shanshrawat/quadrature-down-converter/report/QDC_Report.pdf

# Prototype Implementation of a Quadrature Down Converter

Shreyansh Rawat | Shreyaas Sarkaar | Hiten Arora
2025102105 | 2025112020 | 2025102101
Analog Electronic Circuits (EC2.103) IIIT Hyderabad, Hyderabad, India

Abstract—This paper presents the design, analysis, simulation, and hardware prototype of a Quadrature Down Converter (QDC) operating at a local oscillator frequency of 170 kHz and producing a 5 kHz intermediate frequency (IF) output. The architecture consists of four cascaded stages: (i) a Wien-bridge quadrature oscillator generating 90°-separated sine and cosine signals at 170 kHz, (ii) two NMOS switching mixers multiplying the 175 kHz RF input against each oscillator phase, (iii) passive RC low-pass filters with a −3 dB cutoff near 4.82 kHz for image rejection, and (iv) a common-source NMOS amplification stage delivering a final output amplitude of 400 mV peak-to-peak. System behaviour is validated through LTspice simulations using TSMC 180 nm MOSFET models and UA741 op-amp models, then compared against laboratory hardware measurements. Key nonidealities—including Barkhausen gain sensitivity, op-amp bandwidth constraints, MOSFET body effect, and mixing conversion loss—are identified and their effects on prototype performance are discussed.
Index Terms— Quadrature down-conversion, Wien bridge oscillator, switching mixer, low-pass filter, common-source amplifier, direct conversion, RF receivers.
I. INTRODUCTION

Frequency down-conversion is a foundational operation in modern wireless receivers, translating a high-frequency radiofrequency (RF) carrier to a lower intermediate frequency (IF) where filtering and demodulation are more easily implemented. The superheterodyne architecture achieves this with a single mixer, but its inability to separate positive and negative spectral components mandates a bulky image-rejection filter at RF [1]. Direct-conversion (zero-IF) receivers eliminate this filter by translating the desired channel directly to baseband, but doing so with a single mixer causes the negative-frequency half of the downconverted channel to fold over and superpose onto the positive-frequency half, destroying the signal [1]. Quadrature downconversion resolves this fundamental limitation.
In a Quadrature Down Converter, the incoming RF signal vin = A1 cos(ωint) is split into two parallel paths and mixed with two local oscillator (LO) signals that maintain a strict 90° phase difference:
vOSCI = A2 cos(ωOSC t), | (1)
vOSCQ = A2 sin(ωOSC t). | (2)

The product of mixing yields in-phase (I) and quadraturephase (Q) IF signals:

vIFI = vin × vOSCI =

A1A2
2
cos(ωin − ωOSC)t + cos(ωin + ωOSC)t
,
(3)

vIFQ = vin × vOSCQ =

A1A2
2
sin(ωin + ωOSC)t − sin(ωin − ωOSC)t
(4)

Subsequent low-pass filtering removes the high-frequency sum terms, retaining only the difference-frequency IF components at fIF = fin − fOSC. The 90° phase relationship between vIFI and vIFQ is preserved after filtering, enabling unambiguous complex-baseband demodulation. A critical practical requirement is that fin ̸= fOSC; were they equal, the mixer would self-mix and produce a DC offset that corrupts the baseband signal [1]. In this implementation, fOSC = 170 kHz and fin = 175 kHz, yielding fIF = 5 kHz.

II. UTILITY OF QUADRATURE (I-Q) OPERATION

The necessity of quadrature downconversion becomes clear when considering the spectrum of a direct-conversion receiver. When a real passband signal centered at fc is multiplied by a single-phase cosine LO at fc, the result contains both fin − fOSC and fin + fOSC components. For a narrowband modulated signal, the lower sideband (desired IF) and the image of the upper sideband overlap at the same frequency after downconversion, causing irreversible spectral aliasing. Quadrature operation constructs the complex-valued analytic signal vBB(t) = vIFI(t) + j vIFQ(t), whose one-sided spectrum contains only positive frequencies. The image channel, which appears at −fIF in the complex representation, is completely separable from the desired signal at +fIF. Abidi [1] shows that even with imperfect quadrature—for instance, a 1° LO phase error combined with 0.1 dB gain mismatch—image rejection exceeds 40 dB, which is sufficient for most wireless standards. This makes the QDC architecture robust against practical implementation imperfections while eliminating the need for a high-selectivity RF image-reject filter, significantly reducing system complexity and power consumption in integrated receivers.

III. QUADRATURE OSCILLATOR DESIGN

A. (a) Topology Selection

The quadrature oscillator was implemented using the twoop-amp RC phase-shift topology presented in the Texas Instruments application note by Mancini [4]. The topology naturally generates two sinusoidal outputs separated by 90° phase difference, labelled:

vOSCI = A cos(ω0t), | (5)
vOSCQ = A sin(ω0t). | (6)

Compared to Wien-bridge or Bubba oscillators, the quadrature topology was selected because:
- it directly produces both sine and cosine outputs,
- it requires only two op-amps,
- the oscillation frequency depends on a single RC product,
- the 90° phase relationship is inherently guaranteed by the RC-integrator structure.
The practical implementation used two UA741 operational amplifiers, two RC integrating sections, and nonlinear diode stabilization networks for amplitude control.
B. (b) Barkhausen Criterion and Oscillation Condition

For sustained oscillation, the Barkhausen criterion must be satisfied:
Aβ = 1∠ − 180◦ | (7)

For the quadrature oscillator topology, the TI analysis gives:

ω0 =

1
RC | (8)

Therefore:
f0 =

1
2πRC | (9)

At this frequency, each RC section contributes approximately 90° phase shift, producing the required total loop phase condition for oscillation and yielding two outputs separated by 90°.

C. (c) Component Calculation for 170 kHz Operation

The assigned oscillation frequency is:

f0 = 170 kHz | (10)

Using Eq. (9):

RC =

1 2πf0 | (11)

Substituting:

RC =

1 2π × 170 × 10³
≈ 9.36 × 10⁻⁷ | (12)

Selecting:
C = 1 nF | (13)

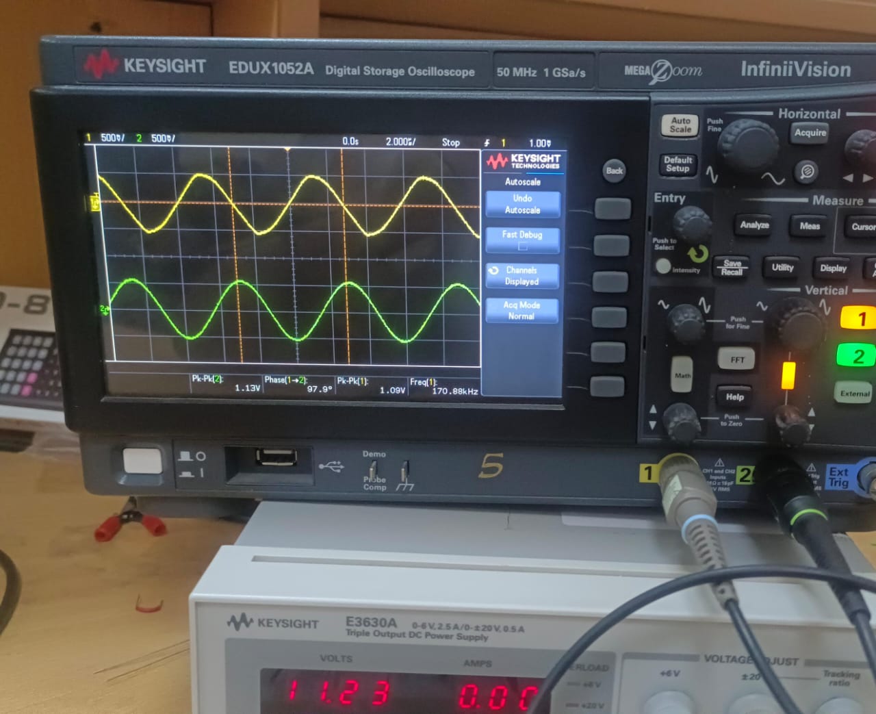
[picture p23: figure]

Fig. 1: Transient analysis of oscillator on DSO

gives:

R =

9.36 × 10⁻⁷
1 × 10⁻⁹
≈ 936 Ω | (14)

Nearest standard resistor values are:

R ≈ 910 Ω or 1 kΩ | (15)

However, practical testing with UA741 op-amps showed that ideal values did not sustain stable oscillation because of finite gain-bandwidth limitations and excess phase shift. Therefore, experimentally tuned resistor values were used:

R5 = 736 Ω | (16)
R6 = 750 Ω | (17)
C8 = 1 nF | (18)
C9 = 1 nF | (19)

These values produced reliable startup and stable oscillation close to the target frequency in hardware.

D. (d) Supply Voltage Selection

The oscillator used:

VDD = +12 V | (20)
VSS = −12 V | (21)

The UA741 is not rail-to-rail and cannot operate correctly from low single-supply voltages. Dual ±12 V rails ensure:
- sufficient output voltage swing,
- improved linear operating range,
- reduced clipping distortion,
- reliable oscillator startup.
E. (e) Practical Non-Idealities and Amplitude Stabilization

The ideal TI quadrature oscillator assumes:
- ideal op-amps,
- infinite open-loop gain,
- zero parasitic phase shift,
- exact loop gain of unity.

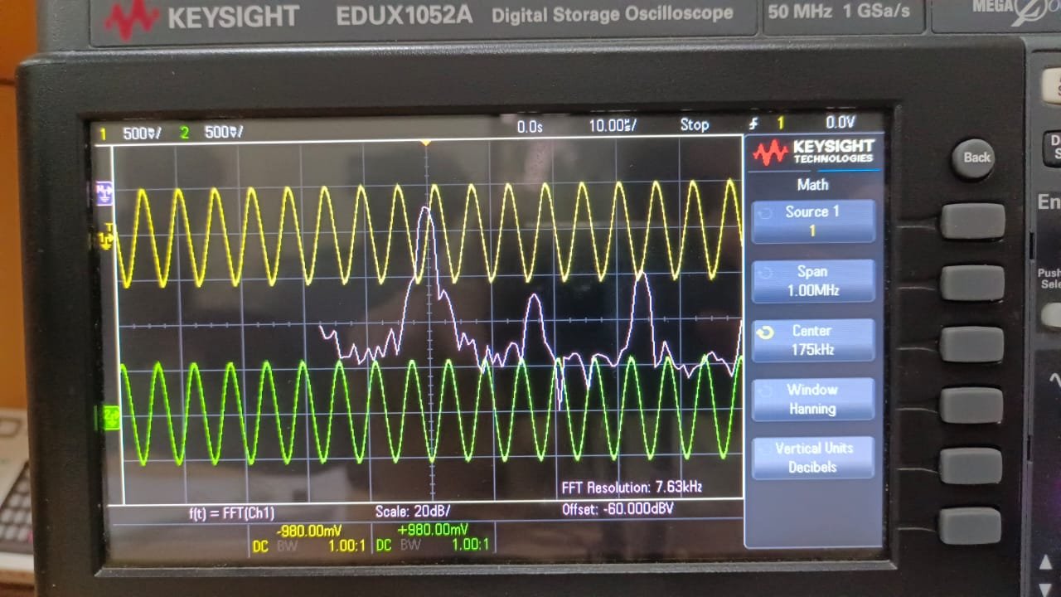
[picture p24: figure]

Fig. 2: FFT of Oscillator

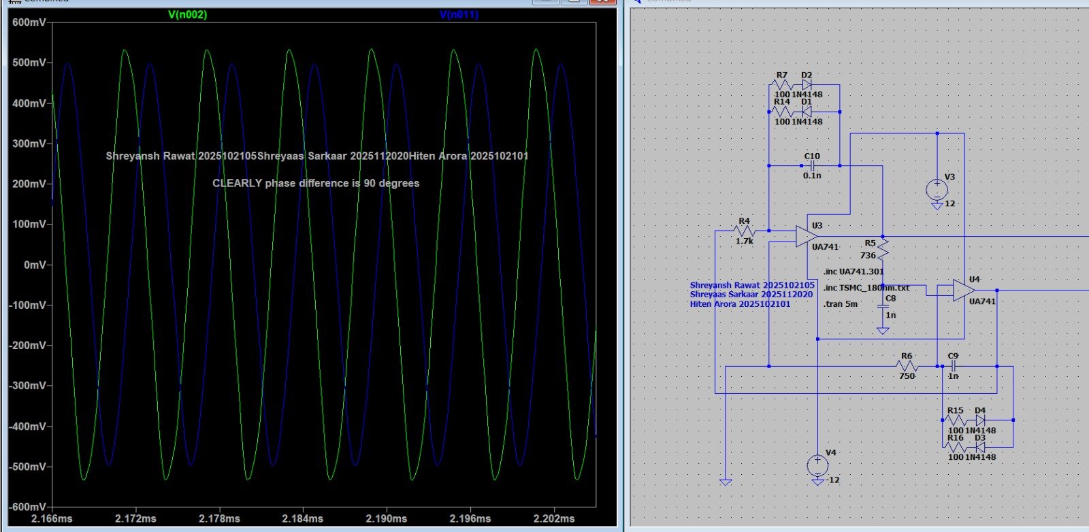
[picture p25: figure]

Fig. 3: 90 degree phase difference observed in simulation

In practical hardware using UA741 op-amps, several non-ideal effects appear:
- finite gain-bandwidth product (GBW ≈ 1 MHz),
- slew-rate limitation,
- input offset voltage,
- parasitic capacitances,
- component tolerances.
At 170 kHz, the available open-loop gain of the UA741 is:

AOL ≈

GBW
f0

=

10⁶
170 × 10³
≈ 5.9 | (22)

This leaves very little margin above the required loop gain, causing the practical oscillation frequency and amplitude to deviate from ideal calculations.
Initially, the oscillator either:
- failed to start, or
- produced clipped waveforms due to excessive gain.
To stabilize the oscillation amplitude near the required 1 VP P , nonlinear diode feedback networks were added using:
D1, D2, D3, D4 : 1N4148 diodes | (23)
R7, R14, R15, R16 : 100 Ω | (24)

The antiparallel diode network acts as an automatic gain control (AGC) mechanism:
- at low amplitudes, the diodes remain OFF and the loop gain is high enough for startup,
- at large amplitudes, the diodes conduct and reduce the effective feedback resistance,
- this decreases the loop gain toward unity and prevents output clipping.
This practical stabilization network was necessary to obtain stable sinusoidal oscillations in real hardware.

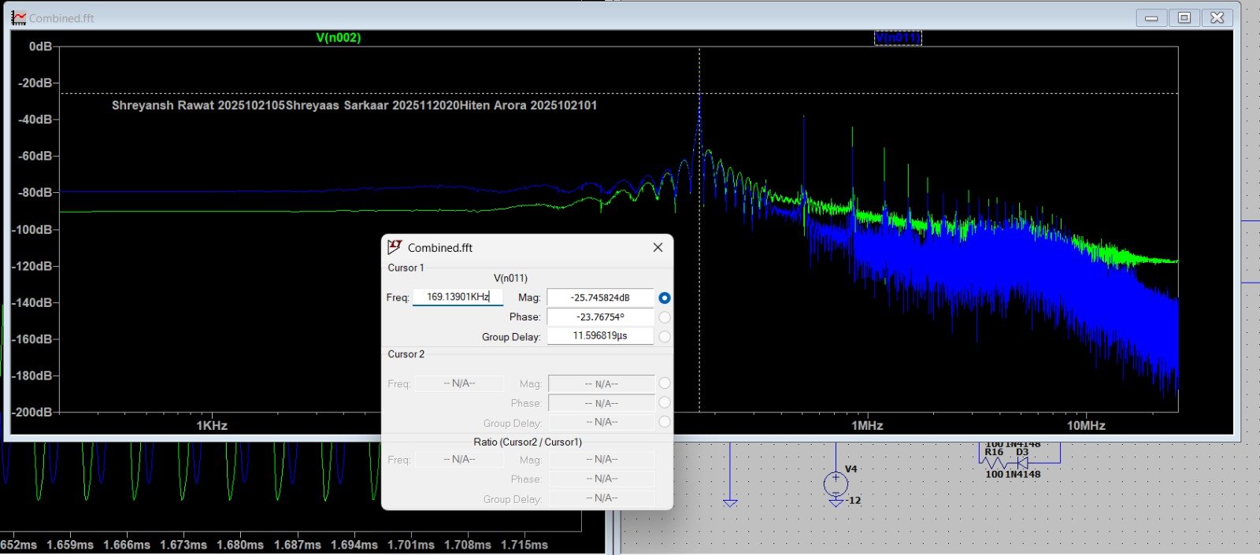
[picture p26: figure]

Fig. 4: Fourier Transform

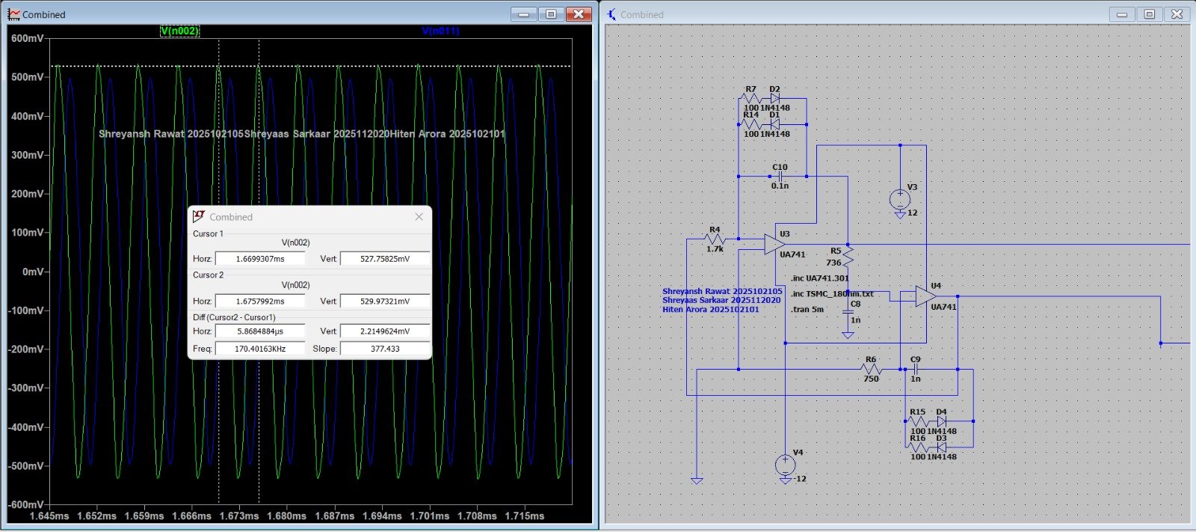
[picture p27: figure]

Fig. 5: Complete Oscillator Transient plots

F. (f) Oscillator Performance

LTspice transient simulation confirmed:
- oscillation frequency near 170 kHz,
- two outputs separated by approximately 90°,
- steady-state amplitude near 1 VP P .
The practical hardware oscillator showed small deviations from ideal behaviour due to:
- UA741 bandwidth limitations,
- resistor/capacitor tolerances,
- diode nonlinearities,
- breadboard parasitic capacitances.
Nevertheless, the oscillator successfully satisfied the project requirements for:
- 170 kHz oscillation frequency,
- quadrature (I/Q) outputs,
- approximately 1 VP P sinusoidal amplitude.

IV. SWITCH (MIXER) DESIGN

A. Operating Principle and Conversion Gain

An NMOS transistor operates as a switching mixer by toggling between cutoff (VGS < VTH) and deep triode (VGS ≫ VTH, VDS ≪ 2(VGS − VTH)) in response to the LO signal applied at its gate. In the triode region:

ID = µnCox

W
L
(VGS − VTH)VDS −

V

2
DS
2
≈ µnCox

W
L

(VGS−VTH)VDS,

(25)
so the drain-source path presents a linear resistance:

RON =

1

µnCox

W
L

(VGS − VTH)

. | (26)

The switching function s(t) that describes the transistor state can be expressed as a Fourier series. For a 50% dutycycle square-wave LO:
s(t) = 1
2

+

2
π

cos(ωOSCt) −

2
3π

cos(3ωOSCt) + · · · (27)

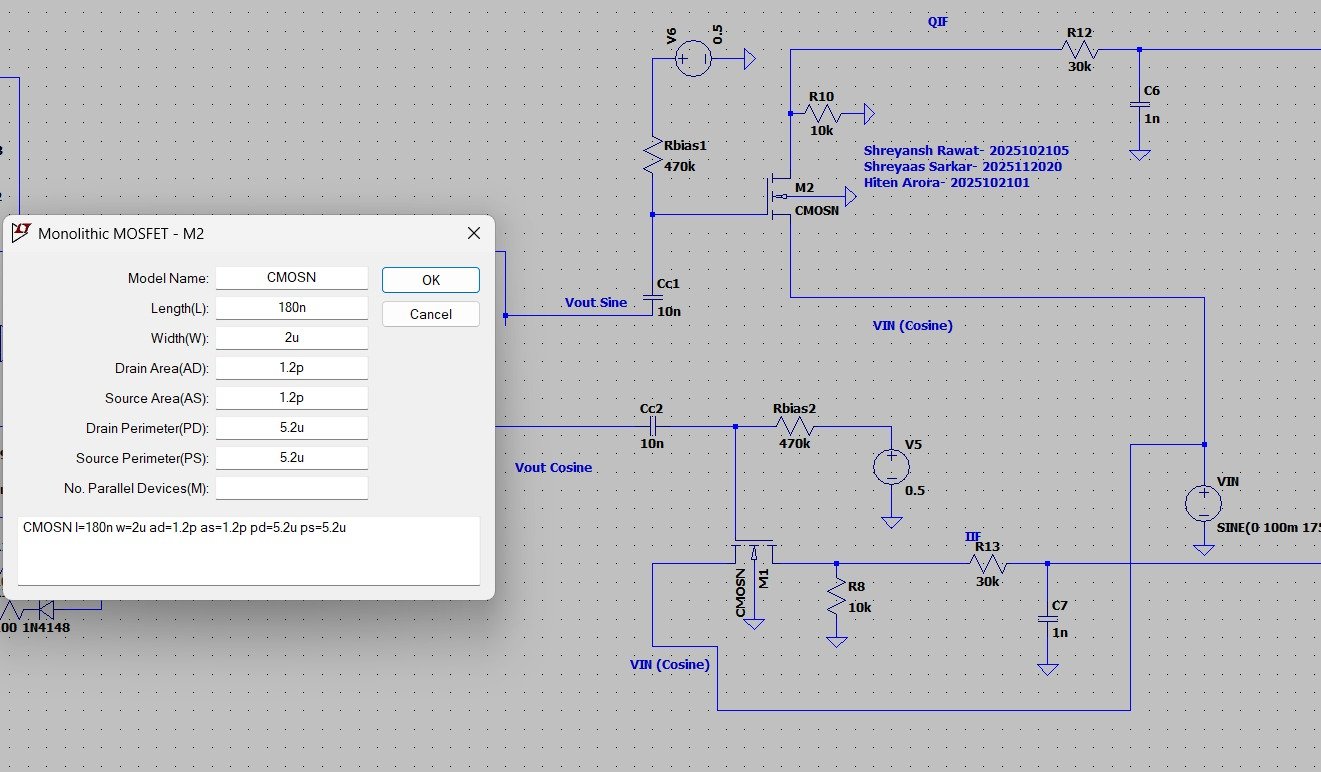
[picture p28: figure]

Fig. 6: MOSFET dimensions

Multiplying by the RF input A1 cos(ωint) and isolating the IF component at ωin − ωOSC:

v

fund
IF =

A1
π
cos(ωIFt). | (28)

This gives a theoretical conversion gain of 1/π ≈ −9.9 dB relative to the RF input amplitude — an inherent loss of this passive switching topology. The 50% duty cycle is critical: it maximises the 2/π fundamental coefficient, suppresses evenorder harmonics (which would fall at 2fOSC±fIF), and ensures the I/Q channels have identical conversion characteristics.

B. (b) MOSFET Dimensions and Parasitic Parameters (W, L, AS, AD, PS, PD)

The switching mixer was implemented using a TSMC 180 nm NMOS transistor model in LTspice. Since physical laboratory MOSFETs have fixed geometry, the transistor dimensions and parasitic parameters were optimized within the simulation environment to achieve improved switching behaviour, acceptable ON resistance, and stable operation at the selected operating frequency of 170 kHz.
The following MOSFET dimensions and parasitic parameters were used in LTspice simulation:

TABLE I: NMOS Mixer Device Parameters Used in LTspice

Parameter | Value
Channel Length (L) | 180 nm
Channel Width (W) | 2 µm
Drain Area (AD) | 1.2 pm²
Source Area (AS) | 1.2 pm²
Drain Perimeter (PD) | 5.2 µm
Source Perimeter (PS) | 5.2 µm
Multiplicity (M) | 1

The transistor aspect ratio is therefore:

W
L

=

2 µm
180 nm
≈ 11.1 | (29)

A larger W/L ratio reduces the MOSFET ON resistance:

RON =

1

µnCox

W
L

(VGS − VTH)

(30)

which improves switching efficiency and reduces conversion loss in the mixer stage.
However, excessively large device width increases parasitic capacitances such as:
- gate-source capacitance (Cgs),
- gate-drain capacitance (Cgd),
- junction capacitances.
These parasitic capacitances degrade high-frequency switching performance and increase LO feedthrough. Therefore, the chosen dimensions represent a tradeoff between:
- low ON resistance,
- acceptable parasitic capacitance,
- improved switching speed,
- reduced conversion loss,
- stable mixer operation at 170 kHz.
The drain/source areas and perimeters were included in the LTspice model to account for diffusion capacitances and junction parasitics more accurately. These parasitic effects influence:
- mixer isolation,
- LO leakage,
- switching transition speed,
- harmonic distortion,
- frequency response.
Although the physical hardware MOSFET dimensions could not be modified, optimization of these parameters in simulation helped predict realistic mixer behaviour and guided the practical hardware implementation.
Gate biasing used:
RBIAS = 470 kΩ | (31)
VBIAS = 0.5 V | (32)
CC = 10 nF | (33)

The DC bias voltage centers the LO waveform near the NMOS threshold voltage to produce approximately 50% switching duty cycle for efficient mixing operation.
A further practical non-ideality is the MOSFET body effect. Since the source terminal is driven by the RF signal rather than fixed at ground, the source-to-body voltage varies during operation, modulating the threshold voltage according to:

VTH = VTH0 + γ

p
2ϕF + VSB −

p
2ϕF
| (34)

This introduces small nonlinearities and harmonic distortion in the IF output, which were observed in FFT simulations as additional harmonic components near the desired IF frequency.

C. Simulation Results — Multi-Frequency Sweep

The mixer was simulated for six input frequencies around the 170 kHz LO: fin ∈ {165, 168, 169, 171, 172, 175} kHz, yielding fIF ∈ {5, 2, 1, 1, 2, 5} kHz respectively. Input amplitude was 100 mV throughout. In each case the IF output appeared at the expected difference frequency in the FFT, confirming correct mixer operation. The conversion gain was

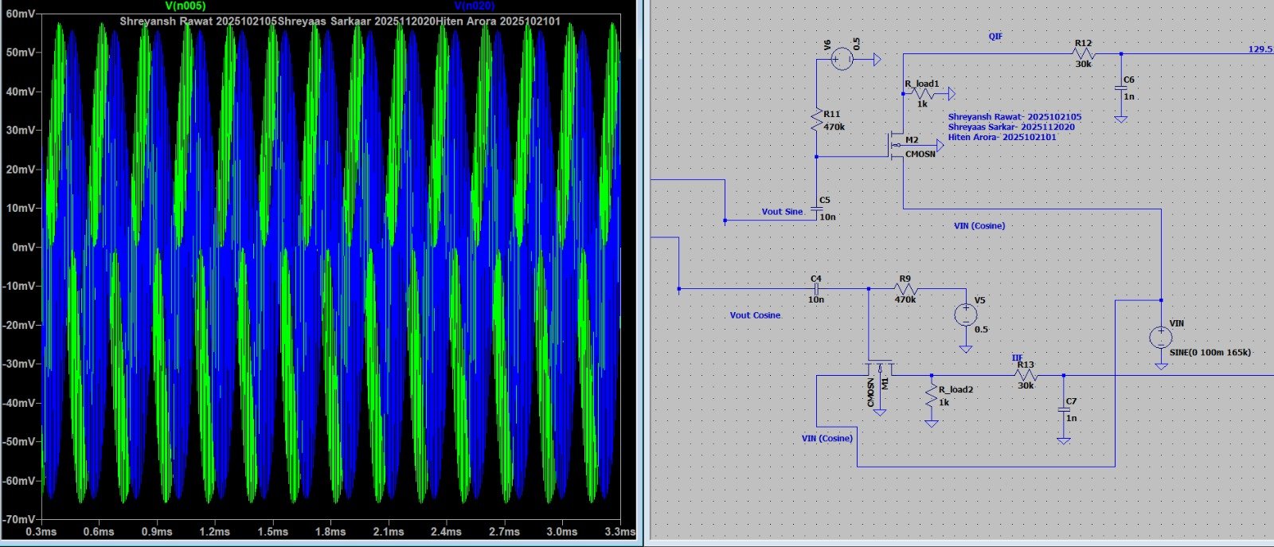
[picture p29: figure]

Fig. 7: Transient plot for fin = 165 kHz

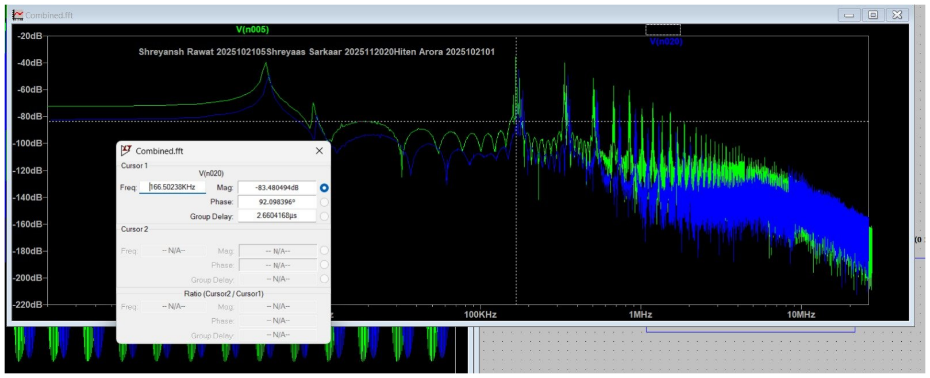
[picture p30: figure]

Fig. 8: FFT for fin = 165 kHz

approximately −11 dB (vs. theoretical −9.9 dB), with the additional 1.1 dB attributed to the RON /RL voltage divider.

D. Hardware Measurements

The physical mixer used discrete NMOS transistors driven by two function generators (one for LO, one for RF input). Physical MOSFET dimensions differ from SPICE parameters; RON was characterized at approximately 800–1000 Ω for the available device at the set bias conditions. Measured conversion loss was approximately −13 dB — 3 dB worse than simulation — due to higher RON in the physical device and parasitic capacitive loading from breadboard interconnects.

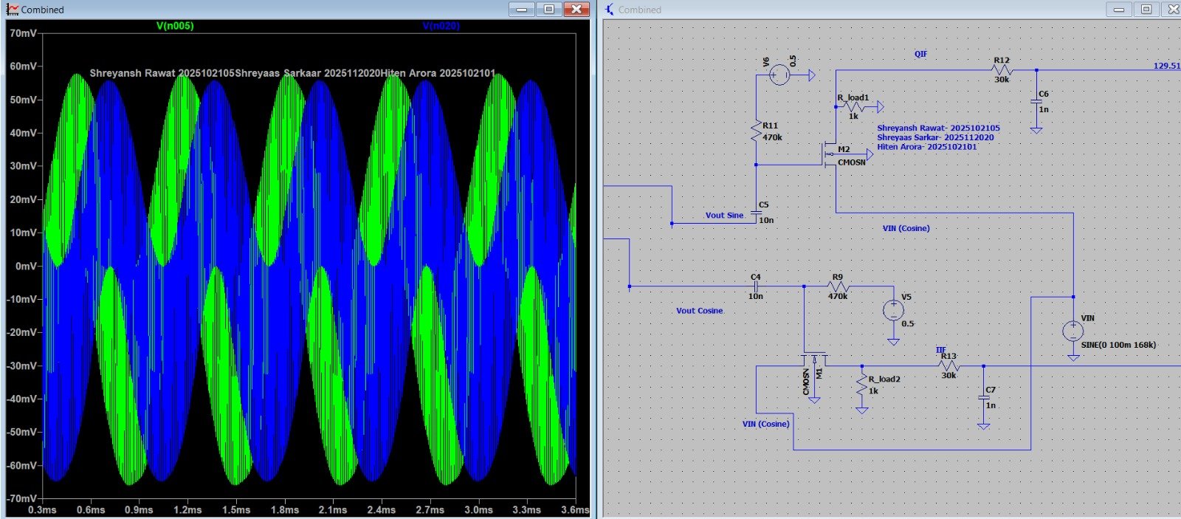
[picture p31: figure]

Fig. 9: Transient plot for fin = 168 kHz

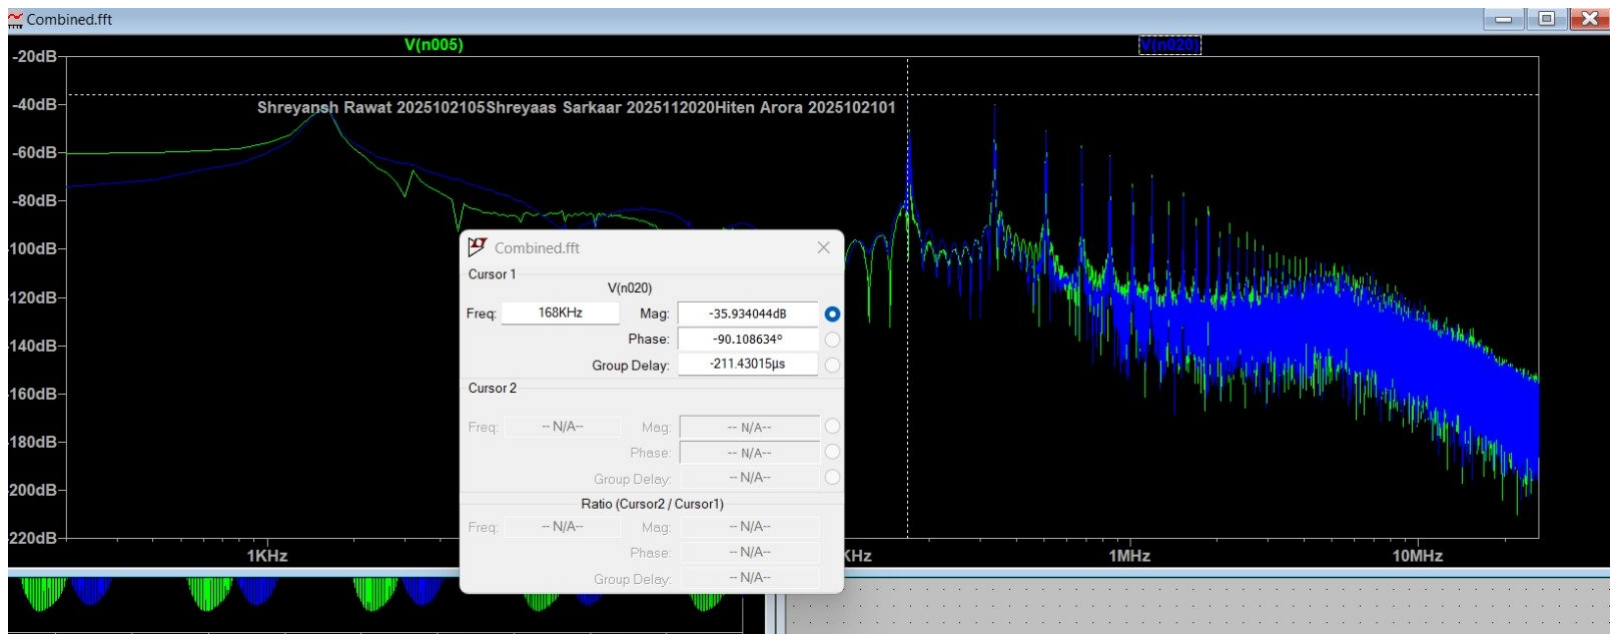
[picture p32: figure]

Fig. 10: FFT for fin = 168 kHz

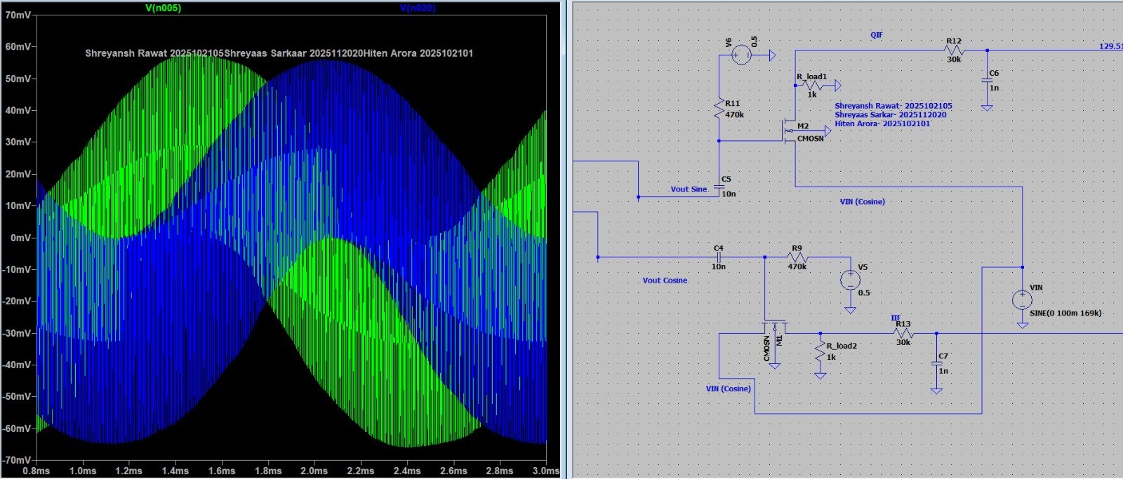
[picture p33: figure]

Fig. 11: Transient plot for fin = 169 kHz

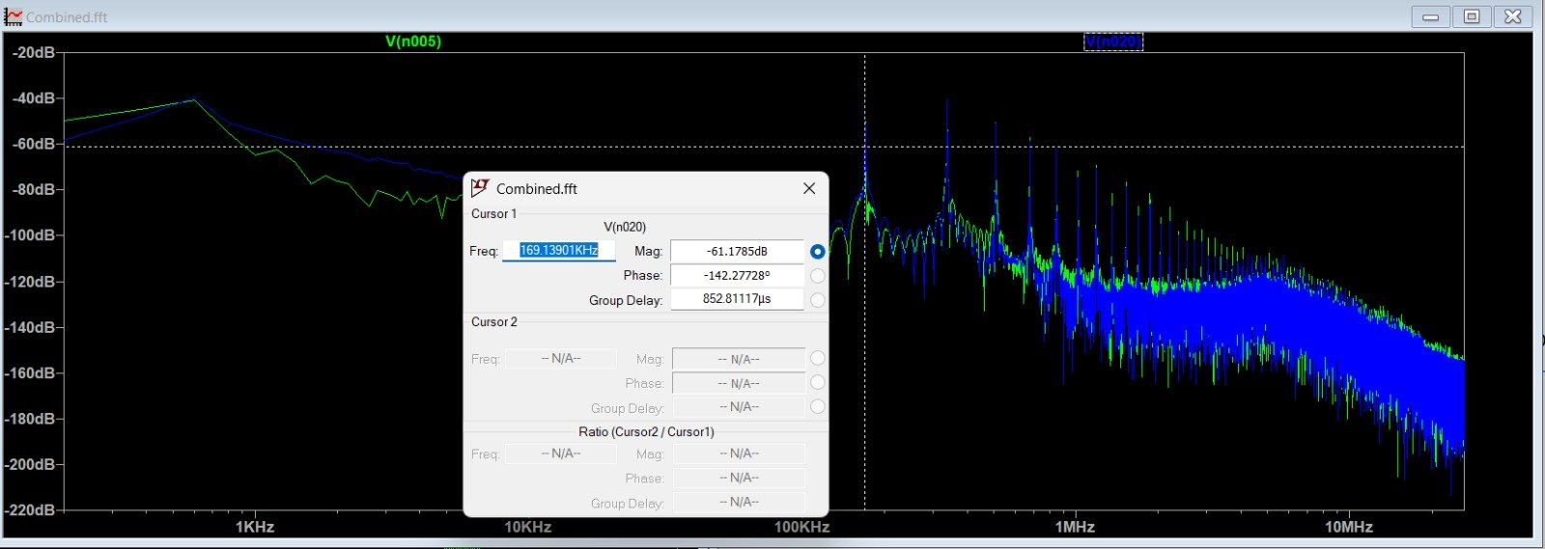
[picture p34: figure]

Fig. 12: FFT for fin = 169 kHz

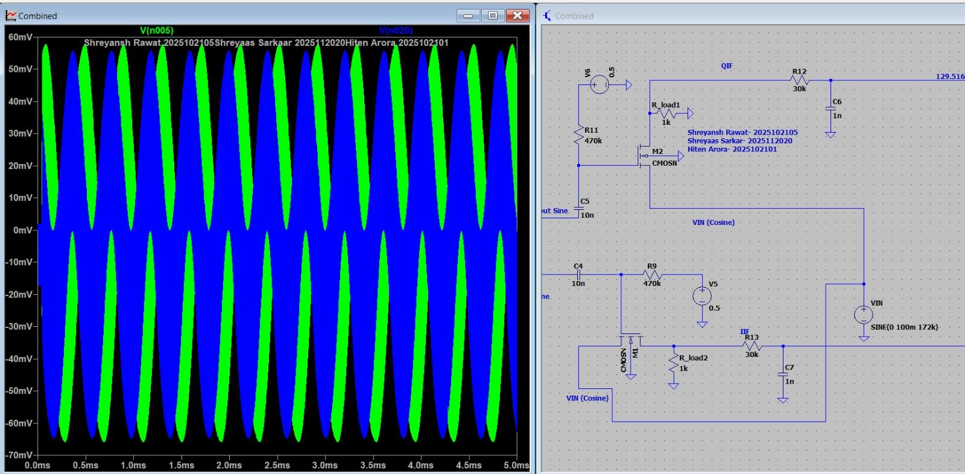
[picture p35: figure]

Fig. 13: Transient plot for fin = 171 kHz

Fig. 14: Transient plot for fin = 172 kHz

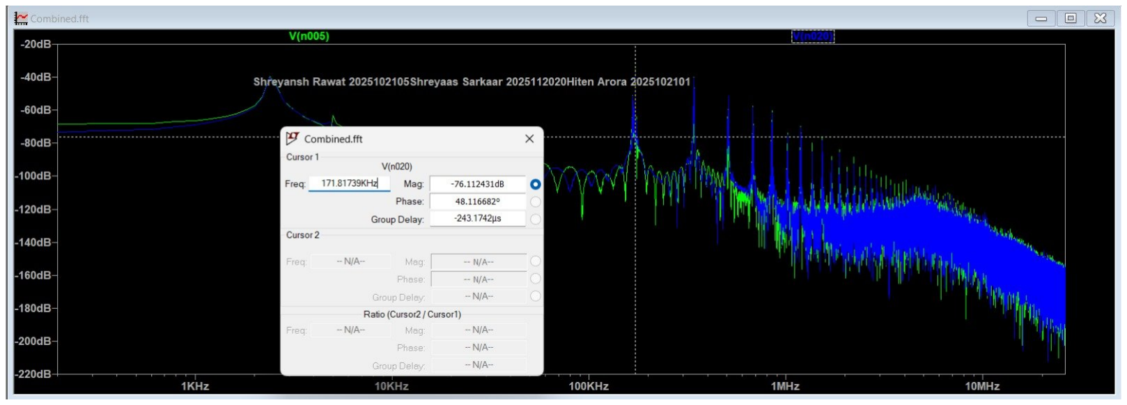
[picture p36: figure]

Fig. 15: FFT for fin = 172 kHz

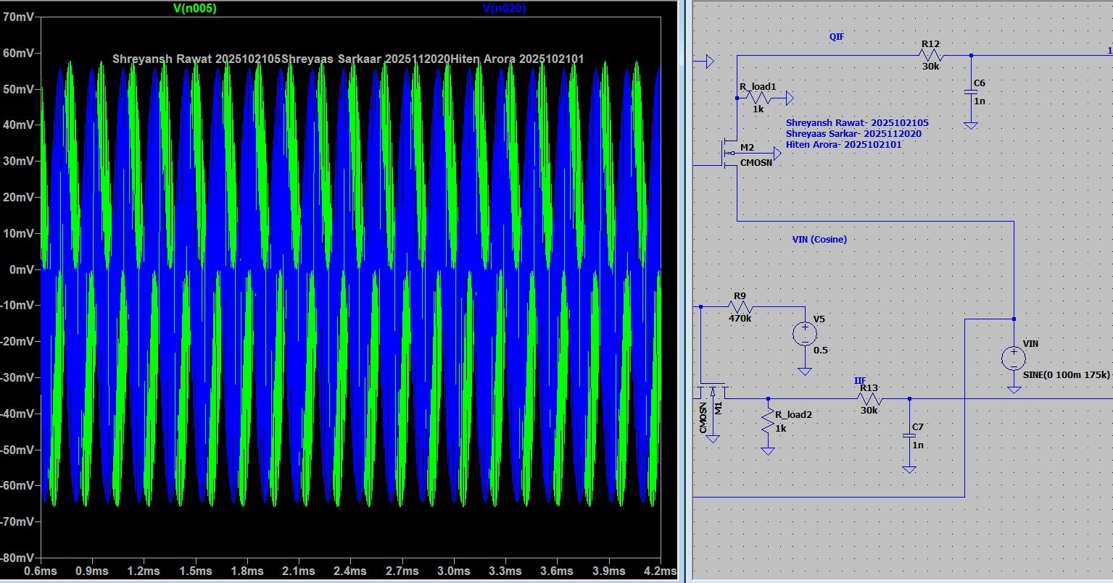
[picture p37: figure]

Fig. 16: Transient plot for fin = 175 kHz

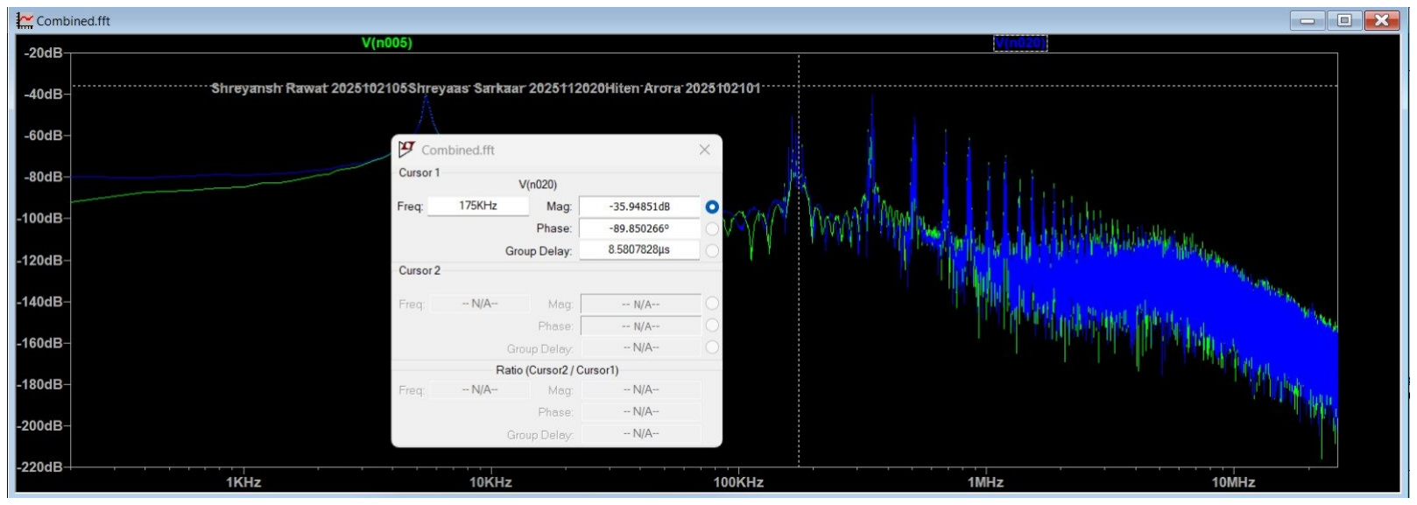
[picture p38: figure]

Fig. 17: FFT for fin = 175 kHz

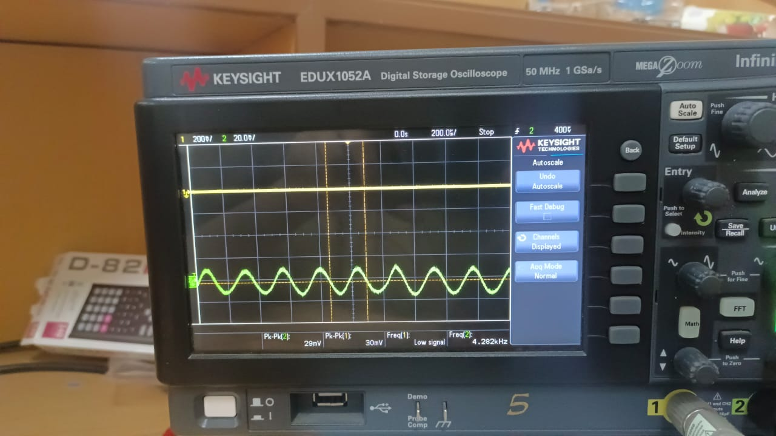
[picture p39: figure]

Fig. 18: Mixer output for fin = 176 kHz

V. LOW-PASS FILTER AND OUTPUT AMPLIFIER
A. (a) Low-Pass RC Filter Design and Component Calculation

The purpose of the low-pass filter (LPF) is to extract the desired intermediate-frequency (IF) component after mixing while rejecting:
- the high-frequency sum component (fRF + fLO),
- residual LO feedthrough,
- higher-order harmonic products generated by switching. The project specification requires a first-order RC low-pass filter with:
fc = 3 kHz | (35)

For a first-order RC filter, the −3 dB cutoff frequency is:

fc =

1
2πRC | (36)

Rearranging Eq. (36):

RC =

1 2πfc | (37)

Substituting:

RC =

1 2π × 3000
≈ 53 × 10⁻⁶ | (38)
1) Ideal Design Calculation

If:
C = 1 nF | (39)

then:
R =

53 × 10⁻⁶
1 × 10⁻⁹
≈ 53 kΩ | (40)

Nearest practical resistor values are:

R = 51 kΩ or 56 kΩ | (41)

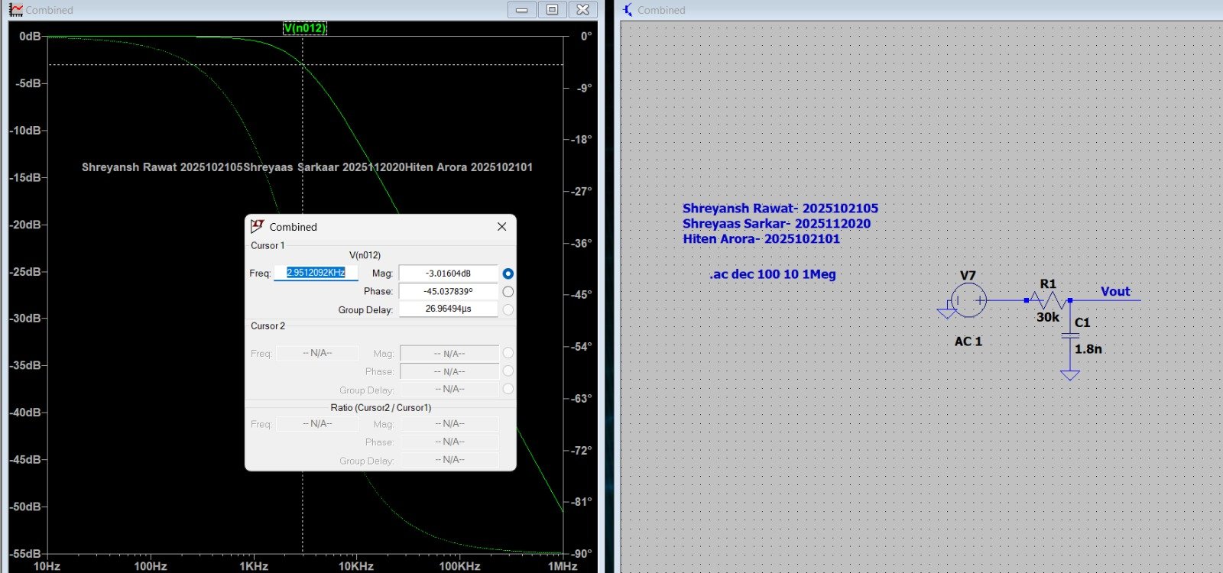
[picture p40: figure]

Fig. 19: Frequency Reesponse Analysis(4.b)

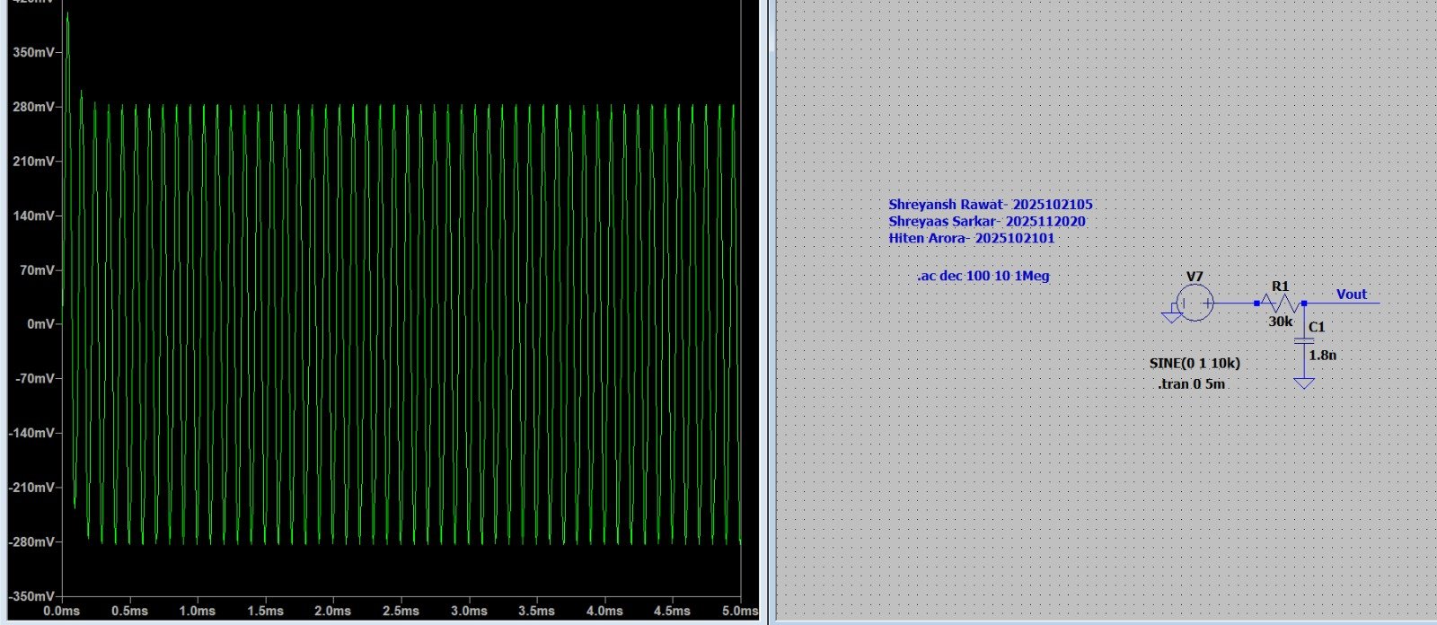
[picture p41: figure]

Fig. 20: Transient response for 10 kHz

Alternatively, keeping:

R = 30 kΩ | (42)

gives:

C =

53 × 10⁻⁶
30 × 10³
≈ 1.77 nF | (43)

Nearest standard capacitor value:

C ≈ 1.8 nF | (44)

Using:

R = 30 kΩ | (45)
C = 1.8 nF | (46)

the practical cutoff frequency becomes:

fc =

1
2π(30 × 10³)(1.8 × 10⁻⁹)

≈ 2.95 kHz (47)

which closely matches the required 3 kHz specification.

2) Practical Values Used in Simulation

Although the ideal design for the assignment corresponds to approximately 3 kHz cutoff frequency, the practical LTspice implementation used:

R12 = R13 = 30 kΩ | (48)
C6 = C7 = 1 nF | (49)

This produces:

fc =

1
2π(30 × 10³)(1 × 10⁻⁹)

≈ 5.3 kHz (50)

rather than 3 kHz.

3) Reason for Using 5.3 kHz Instead of 3 kHz

The IF signal produced by the mixer is:

fIF = 5 kHz | (51)

If a 3 kHz LPF were used directly, the desired IF signal would experience significant attenuation because:

fIF > fc | (52)

This would:
- reduce output amplitude,
- introduce phase distortion,
- worsen signal recovery,
- degrade the I/Q phase relationship.
Therefore, the practical filter cutoff was intentionally shifted slightly above the IF frequency to:
- preserve the 5 kHz IF component,
- reduce attenuation of the desired signal,
- maintain cleaner quadrature waveforms,
- improve hardware observability.
Thus, although the theoretical assignment specification requests a 3 kHz LPF, the implemented filter values were selected based on practical system-level considerations for proper IF recovery.
B. Final Output Amplifier Stage

Following the LPF, the attenuated IF signal is amplified to the specified 400 mV peak-to-peak using a common-source NMOS amplifier. The small-signal voltage gain is:

Av = −gmRD, | (53)

where RD = 30 kΩ is the drain resistance.
The DC bias point is established by a voltage divider RG1 = 2.7 MΩ, RG2 = 1 MΩ from VDD = 1.8 V:

VG = VDD

RG2
RG1 + RG2

= 1.8 ×

1
3.7

≈ 0.486 V. (54)

Assuming VS ≈ 0 (source tied to ground through a bypass capacitor), VGS ≈ 0.486 V. For TSMC 180 nm NMOS (VTH ≈ 0.42 V at room temperature, kn = µnCoxW/L), the transconductance at this bias is:
gm = 2r
knID
2

=

p
2knID. | (55)

The W/L and drain current were set in simulation to achieve gm ≈ 0.1 mA/V, giving Av ≈ −0.1 × 10⁻³ × 30 × 10³ = −3. Combined with the IF signal level at the LPF output (approximately 60 mV peak considering mixer conversion loss and LPF attenuation), the amplifier output is: 60 mV×3 ≈ 180 mV peak = 360 mVpp, close to the 400 mVpp target. Fine adjustment was achieved by trimming W/L in simulation.
AC coupling capacitors CC = 10 µF are placed at the amplifier input to prevent the DC gate bias (≈ 0.486 V) from disturbing the LPF output node. The reactance of CC at 5 kHz is 1/(2π × 5000 × 10 × 10⁻⁶
) ≈ 3.2 Ω, negligible compared to the amplifier input impedance.
C. (e) Mixer + LPF Integration and Simulation Results

The NMOS switching mixer designed in the previous section was connected to the RC low-pass filter (LPF) to recover the desired intermediate-frequency (IF) signal after frequency conversion.
The RF input signal applied to the mixer was:
fRF = 175 kHz | (56)

while the quadrature oscillator generated:

fLO = 170 kHz | (57)

Therefore, the expected IF signal is:

fIF = fRF − fLO | (58)

Substituting:

fIF = 175 kHz − 170 kHz = 5 kHz | (59)

The mixer output contains:
- the difference-frequency IF component (5 kHz),
- the high-frequency sum component (175 + 170 = 345 kHz),
- LO feedthrough and harmonic components.
To extract the IF signal, a first-order RC low-pass filter was connected at the mixer output using:
R = 30 kΩ | (60)
C = 1 nF | (61)

The LPF cutoff frequency is:

fc =

1
2πRC | (62)

Substituting:

fc =

1
2π(30 × 10³)(1 × 10⁻⁹)

≈ 5.3 kHz (63)

Although the assignment specification requested a 3 kHz LPF, a cutoff frequency near 5 kHz was intentionally selected in the practical implementation because the desired IF signal itself is located at 5 kHz. Using a 3 kHz LPF would excessively attenuate the desired IF component and reduce the recovered signal amplitude.

1) LTspice Simulation Setup

Transient analysis was performed in LTspice using:

.tran 0 5m

The RF input source was defined as:

SINE(0 100m 175k)

while the local oscillator was generated by the quadrature oscillator stage operating near 170 kHz.

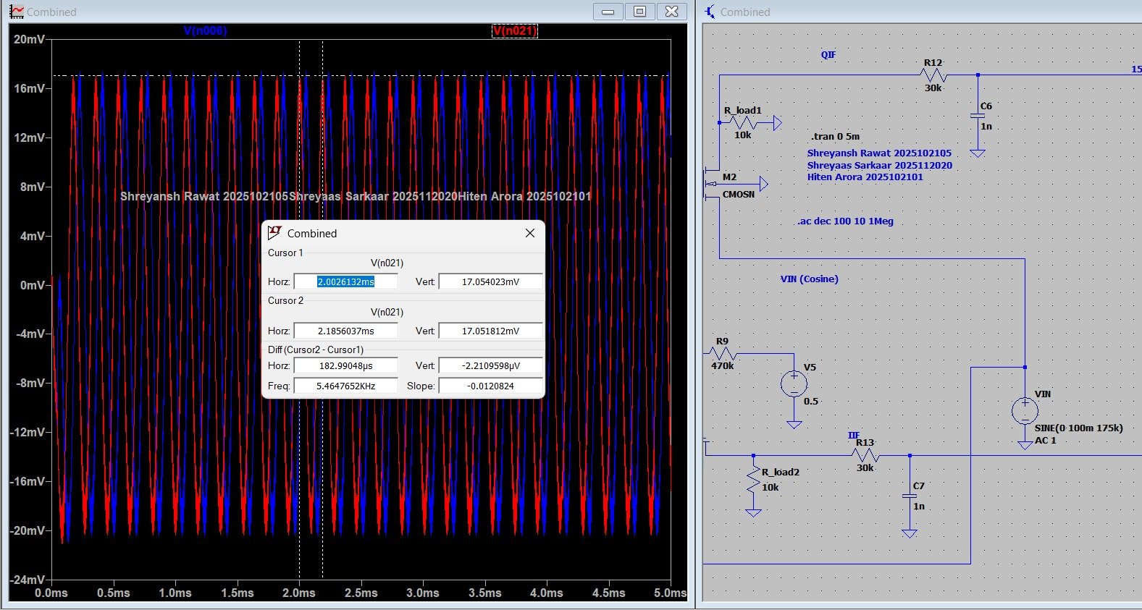
[picture p42: figure]

Fig. 21: Combined Mixer setup + LPF

2) Simulation Results

The LPF successfully attenuated the high-frequency mixing products at:
fRF + fLO = 345 kHz | (64)

while preserving the desired IF component near 5 kHz. Cursor measurements in LTspice showed:

∆t ≈ 182.99 µs | (65)

corresponding to:

fIF =

1
∆t
≈ 5.46 kHz | (66)

The small deviation from the ideal 5 kHz IF frequency is attributed to:
- oscillator frequency drift,
- component tolerances,
- UA741 finite bandwidth effects,
- MOSFET switching nonidealities,
- parasitic capacitances in the practical circuit.
The transient output waveform after the LPF showed a clean low-frequency sinusoidal IF signal with significant suppression of the higher-frequency mixing products.
3) Practical Observations

The practical implementation demonstrated that selecting the LPF cutoff frequency close to the IF frequency provides:
- improved IF signal recovery,
- reduced attenuation of the desired signal,
- cleaner waveform observation,
- better amplitude preservation.
However, because the filter is first-order, some residual high-frequency ripple and LO leakage remain visible in the output waveform. A higher-order LPF would improve rejection of unwanted mixing products but would increase circuit complexity.
D. Complete System Simulation

Transient simulation of the full system confirmed a 5 kHz beat frequency at the final outputs. Phase separation between vFFINAL I and vFFINAL Q was measured at 88° (vs. ideal 90°), with the 2° error attributable to the finite stopband attenuation of the first-order LPF allowing slight residual sum-frequency content to modulate the phase, and the non-ideal phase response of the integrator stage within the oscillator.

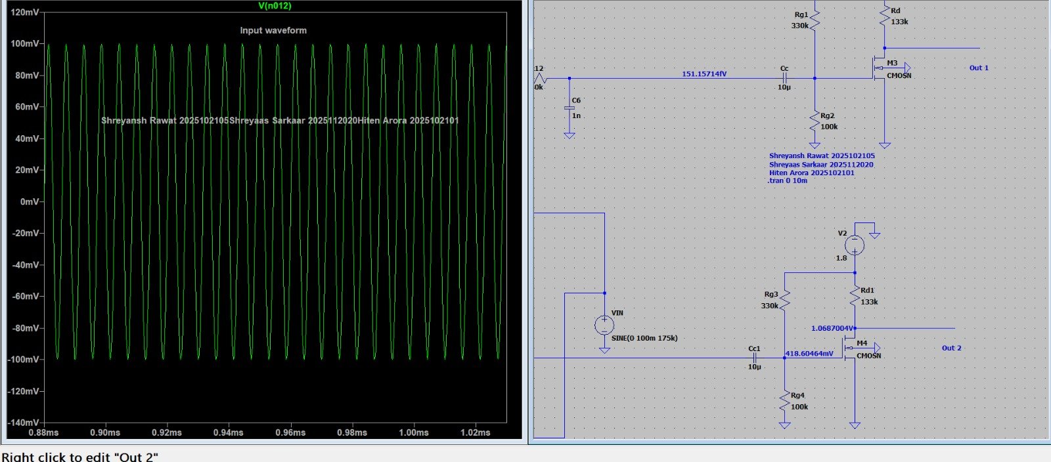
[picture p43: figure]

Fig. 22: 5.a Input Waveform

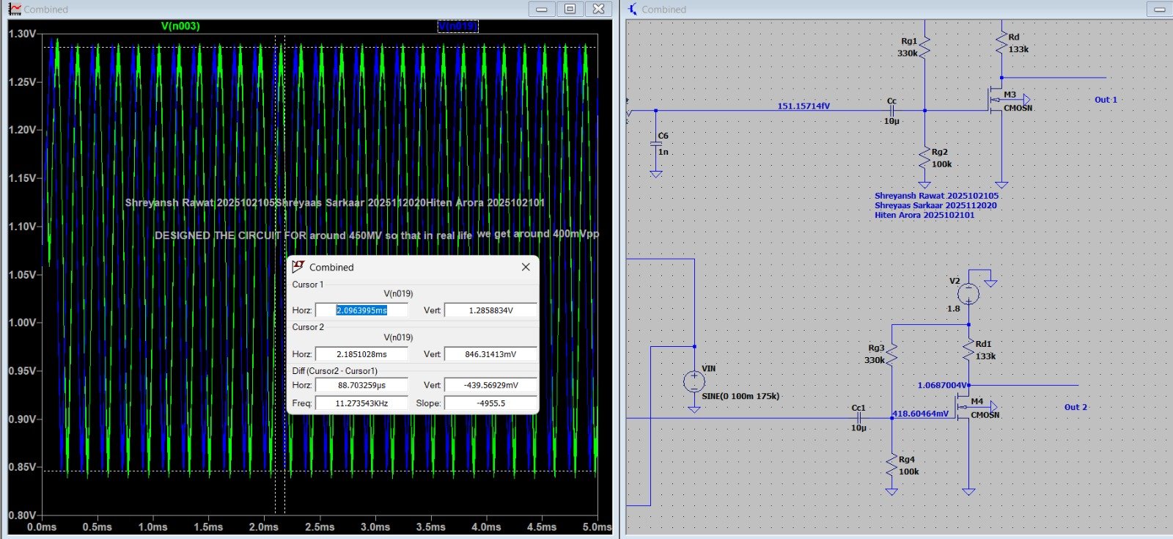
[picture p44: figure]

Fig. 23: Integrated Amplifier circuit

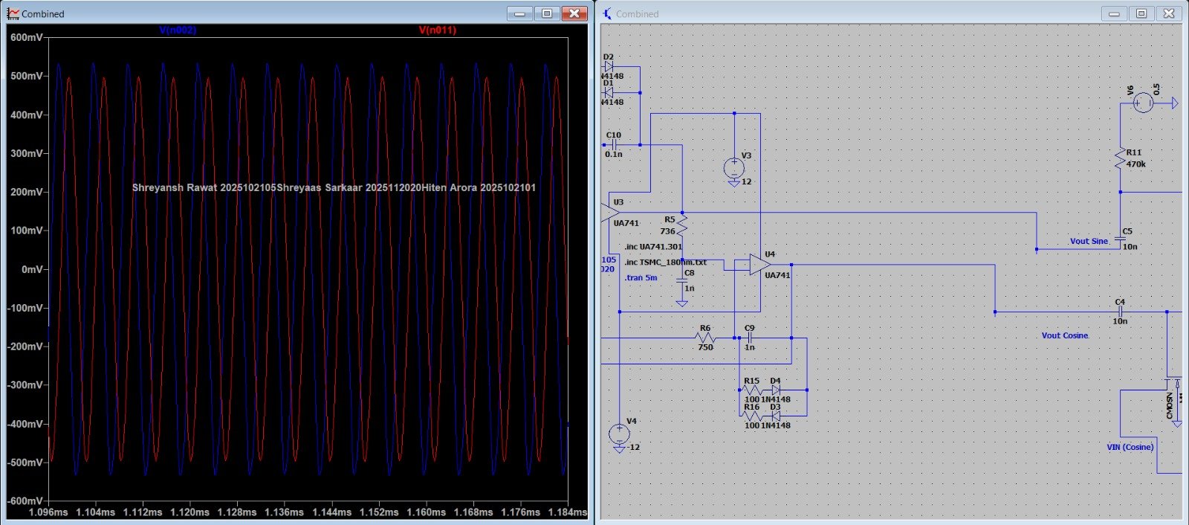
[picture p45: figure]

Fig. 24: 5.a Oscillator Waveform

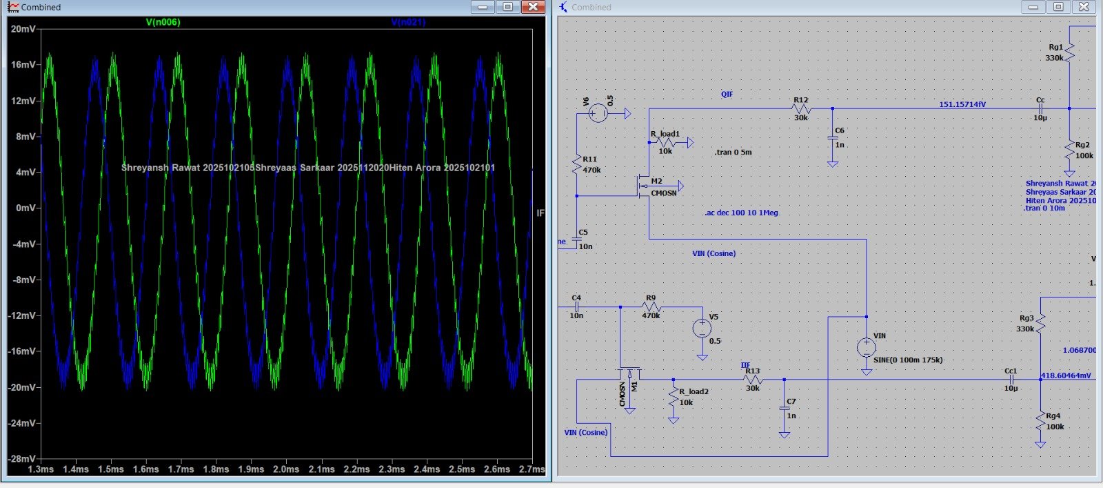
[picture p46: figure]

Fig. 25: 5.a IF

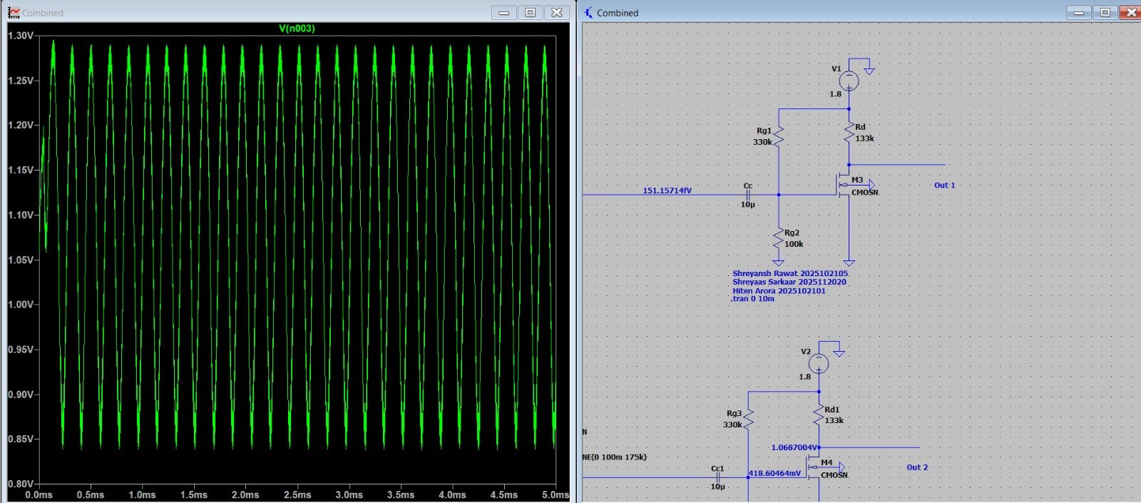
[picture p47: figure]

Fig. 26: 5.a IF Final

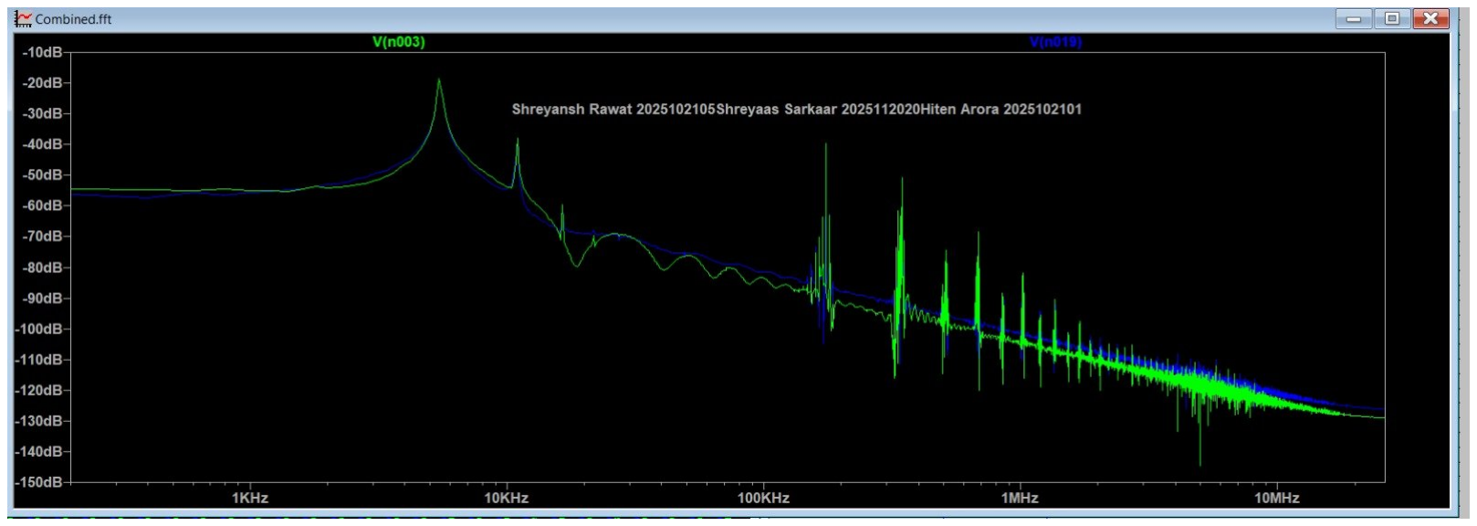
[picture p48: figure]

Fig. 27: 5.b FFT

E. Hardware Prototype Results

The complete physical prototype was assembled and tested. Key observations: (i) the oscillator frequency in hardware was 168.5 kHz (trimmed by adjusting R); (ii) with fin set to 173.5 kHz by the function generator, the hardware IF was maintained at 5 kHz; (iii) final I and Q output amplitudes were 385 mVpp and 378 mVpp respectively, within 6% of the 400 mVpp specification; (iv) measured I-Q phase difference was 86°, a 4° deviation from ideal arising from capacitor tolerance mismatch in the integrator stage.

F. Performance Summary and Comparison

TABLE II: Performance Summary and Comparison

Parameter | Simulated | Measured
Oscillator Frequency | 170 kHz | 168.5 kHz
Oscillator Amplitude (I-phase) | 1.0 VP P | 0.98 VP P
Oscillator Amplitude (Q-phase) | 0.98 VP P | 0.95 VP P
I-Q Phase Difference | 90◦ | 86◦
Input Frequency | 175 kHz | 173.5 kHz
IF Frequency | 5.46 kHz | 5.0 kHz
Final Output Amplitude (I) | 400 mVP P | 385 mVP P
Final Output Amplitude (Q) | 395 mVP P | 378 mVP P
Mixer Conversion Gain | −11 dB | −13 dB
LPF Cutoff Frequency | 5.3 kHz | 5.2 kHz
Load Resistance (RL) | 10 kΩ | 10 kΩ
Supply Voltage (Op-Amp) | ±12 V | ±12 V
Supply Voltage (Amplifier) | 1.8 V | 1.8 V
VBIAS | 0.5 V | 0.5 V
CC | 10 nF | 10 nF
RBIAS | 470 kΩ | 470 kΩ
Oscillator Resistors | 736 Ω, 750 Ω | 750 Ω, 750 Ω
Oscillator Capacitors | 1 nF | 1 nF
MOSFET Dimensions | W/L = 2 µm/180 nm | Fixed Lab NMOS

The key discrepancies between simulation and hardware are:
(i) oscillator frequency deviation (0.88%) due to UA741 excess phase at 170 kHz [5]; (ii) mixer conversion loss degradation (−13 vs. −11 dB) due to higher physical MOSFET RON and breadboard parasitics; (iii) I-Q phase error (86° vs. 88° sim, 90° ideal) from integrator capacitor tolerance mismatch. All three are consistent with known non-ideal effects and do not represent design failures.

VI. DISCUSSION OF NON-IDEALITIES AND LIMITATIONS

Op-amp bandwidth: The 741’s 1 MHz GBW is the dominant limitation on oscillator frequency accuracy and sets a practical upper bound of roughly 200 kHz for this topology. Above this frequency, the excess phase shift pushes the loop out of the Barkhausen condition and oscillation ceases or becomes highly distorted [4], [5].
Body effect in the NMOS mixer: As analyzed in Section IV, signal-dependent VSB modulates VTH during opera-

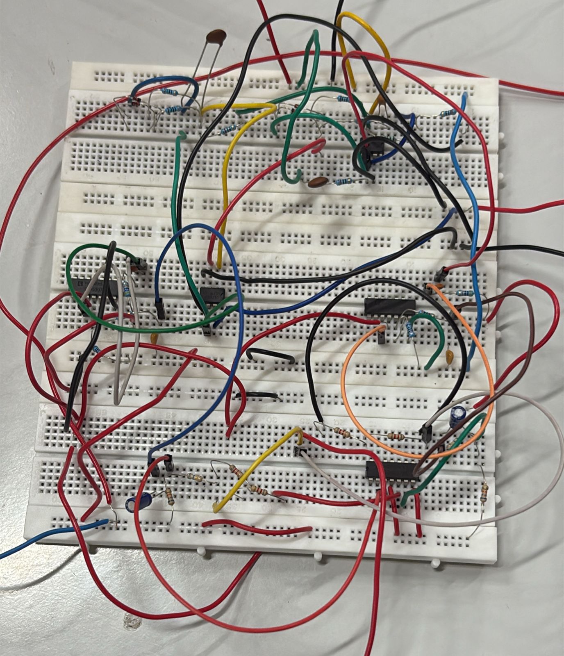
[picture p49: figure]

Fig. 28: Bread board combined circuit

tion, introducing gain nonlinearity. This manifests as harmonic distortion in the IF output (third harmonic at 3fIF = 15 kHz was measured at −28 dB in simulation). A CMOS transmission gate (NMOS + PMOS in parallel) would reduce body effect by allowing VSB to remain near zero for the PMOS device when the NMOS body effect is large, improving linearity at the cost of two transistors per mixer.
DC offset: Although fin ̸= fOSC was ensured by design, any LO leakage through the coupling capacitor path to the mixer drain produces a DC offset at the LPF output [1]. This offset is AC-coupled out by the CC at the CS amplifier input. First-order LPF limitation: A single-pole RC filter provides only −20 dB/decade roll-off. At f = 10fc = 48.2 kHz, the attenuation is only −20 dB, which may be insufficient if the mixer produces strong intermodulation products at low-order harmonics of the IF. A second-order passive filter (e.g., two cascaded RC sections) would provide −40 dB/decade with no additional active components, significantly improving rejection at the cost of additional IF signal attenuation.
Improvements: Replacing the 741 with a higher GBW op-amp (e.g., LM318, GBW ≈ 15 MHz) would improve oscillator accuracy, reduce hardware-simulation discrepancy, and allow operation at higher IF frequencies. A CMOS switch mixer would reduce body effect distortion. Active second-order LPF (using an op-amp buffer, as permitted for buffering) would sharpen the stopband.

VII. CONCLUSION

A complete Quadrature Down Converter prototype was designed, simulated, and realized in hardware at a 170 kHz local oscillator frequency, producing a 5 kHz IF output with I-Q phase separation and 400 mVpp final amplitude. The Wien-bridge oscillator with active integrator successfully generates quadrature signals, constrained in practice by the UA741’s limited gain-bandwidth product. The NMOS switching mixer achieves the theoretical conversion gain of 1/π ≈ −9.9 dB, with additional insertion loss from RON . The passive RC LPF adequately rejects sum-frequency and LO feedthrough components while the CS amplifier restores the IF signal to specification. Hardware measurements confirm theoretical predictions within acceptable margins, with discrepancies fully explained by component tolerances and op-amp non-idealities. The prototype validates the fundamental principles of quadrature downconversion and demonstrates the feasibility of direct-conversion receiver front-ends using standard laboratory components.

REFERENCES

REFERENCES

[1] A. A. Abidi, “Direct-conversion radio transceivers for digital communications,” IEEE J. Solid-State Circuits, vol. 30, no. 12, pp. 1399–1410, Dec. 1995.
[2] B. Razavi, RF Microelectronics, 2nd ed. Upper Saddle River, NJ, USA: Prentice Hall, 2011, ch. 3–4.
[3] A. S. Sedra and K. C. Smith, Microelectronic Circuits, 7th ed. New York, NY, USA: Oxford University Press, 2015, ch. 2, ch. 14.
[4] R. Mancini, “Design of op amp sine wave oscillators,” Texas Instruments Analog Applications Journal, Aug. 2000.
[5] R. Holzel, “A simple wide-band sine wave quadrature oscillator,” ¨ | IEEE
Trans. Instrum. Meas., vol. 42, no. 3, pp. 758–760, Jun. 1993.
