shanshrawat/quadrature-down-converter/media/schematics/quadrature_oscillator.png

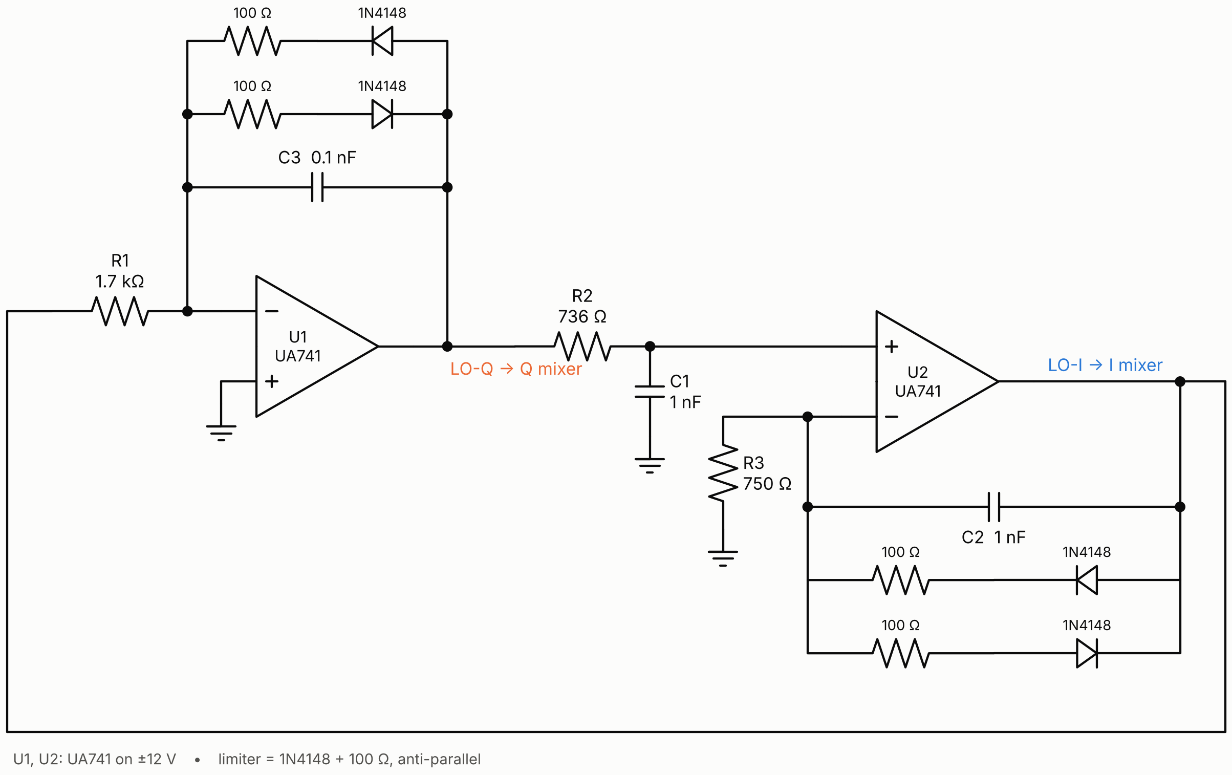
media/schematics/quadrature_oscillator.png
