shanshrawat/quadrature-down-converter/media/schematics/signal_path.png

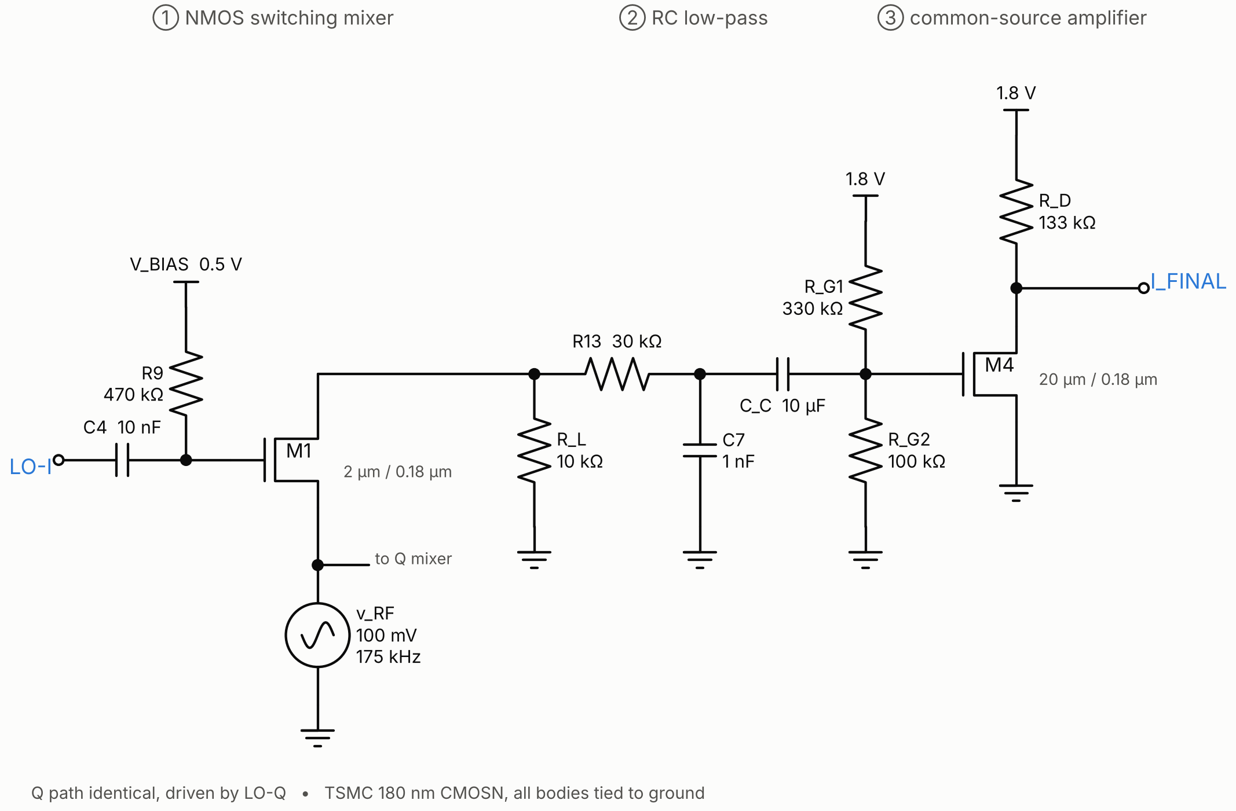
media/schematics/signal_path.png
