shanshrawat/quadrature-down-converter/simulation/oscillator.asc

C1: cap; 1n
C2: cap; 1n
C3: cap; 0.1n
D1: diode; 1N4148
D2: diode; 1N4148
D7: diode; 1N4148
D8: diode; 1N4148
R1: res; 1.7k
R2: res; 736
R3: res; 750
R4: res; 100
R5: res; 100
R6: res; 100
R7: res; 100
U1: UA741
U2: UA741
V1: voltage; 12
V2: voltage; -12
Named nets: 0
Vout Cosine
.inc TSMC_180nm.txt
.lib UA741.301
.tran 1m
