shanshrawat/quadrature-down-converter/simulation/qdc_full_system.asc

C4: cap; 10n
C5: cap; 10n
C6: cap; 1n
C7: cap; 1n
C8: cap; 1n
C9: cap; 1n
C10: cap; 0.1n
Cc1: cap; 10u
Cc: cap; 10u
D1: diode; 1N4148
D2: diode; 1N4148
D3: diode; 1N4148
D4: diode; 1N4148
M1: nmos4; CMOSN; l=180n w=2u ad=1.2p as=1.2p pd=5.2u ps=5.2u
M2: nmos4; CMOSN; l=180n w=2u ad=1.2p as=1.2p pd=5.2u ps=5.2u
M3: nmos4; CMOSN; l=180n w=20u ad=12p as=12p pd=41.2u ps=41.2u
M4: nmos4; CMOSN; l=180n w=20u ad=12p as=12p pd=41.2u ps=41.2u
R4: res; 1.7k
R5: res; 736
R6: res; 750
R7: res; 100
R9: res; 470k
R11: res; 470k
R12: res; 30k
R13: res; 30k
R14: res; 100
R15: res; 100
R16: res; 100
R_load1: res; 10k
R_load2: res; 10k
Rd1: res; 133k
Rd: res; 133k
Rg1: res; 330k
Rg2: res; 100k
Rg3: res; 330k
Rg4: res; 100k
U3: UA741
U4: UA741
V1: voltage; 1.8
V2: voltage; 1.8
V3: voltage; 12
V4: voltage; -12
V5: voltage; 0.5
V6: voltage; 0.5
VIN: voltage; SINE(0 100m 175k)
Named nets: 0
Vout Sine
Vout Cosine
.inc TSMC_180nm.txt
.inc UA741.301
QIF
IIF
VIN (Cosine)
VIN (Cosine)
Out 1
Out 2
.tran 5m
Shreyansh Rawat 2025102105
Shreyaas Sarkaar 2025112020
Hiten Arora 2025102101
.ac dec 100 10 1Meg
.tran 0 5m
Shreyansh Rawat 2025102105
Shreyaas Sarkaar 2025112020
Hiten Arora 2025102101
.tran 0 10m
