shanshrawat/quadrature-down-converter/(commit log)

2026-10-06 Quadrature down converter: design, simulation and hardware prototype
2026-10-06 README: drop team section, move hardware photos to the end; give schematics an opaque background for dark mode
